sahangunasekara/LUX-Meter/README.md

# LUX-Meter

Designing a high precision Lux meter using a Photo‑transistor and OpAmaps, to accurately measure light intensity values in the range 20‑20000 lux
