sahangunasekara/LUX-Meter/(list of files, drawings)

Other design files:
Simulation and Implementation/Physical edits.ms14
Simulation and Implementation/Physical Implementation.ms14
Simulation and Implementation/Test simulation 2.ms14
Simulation and Implementation/Test Simulation 3.ms14
Simulation and Implementation/Test Sumilation 1.ms14
